jitendraphand/physical-AI-development-kit/projects/shiftgate-rover/media/shiftgate_arena_overview.png

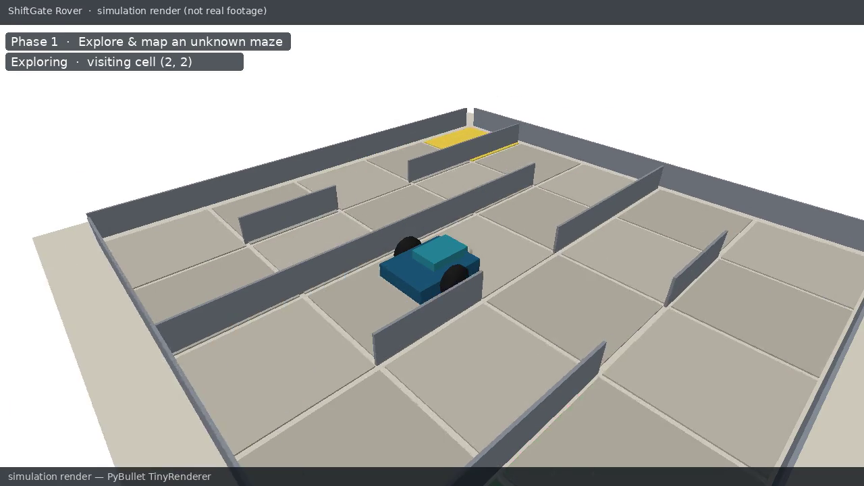
projects/shiftgate-rover/media/shiftgate_arena_overview.png
