jitendraphand/physical-AI-development-kit/projects/shiftgate-rover/cad/step/wheel.step

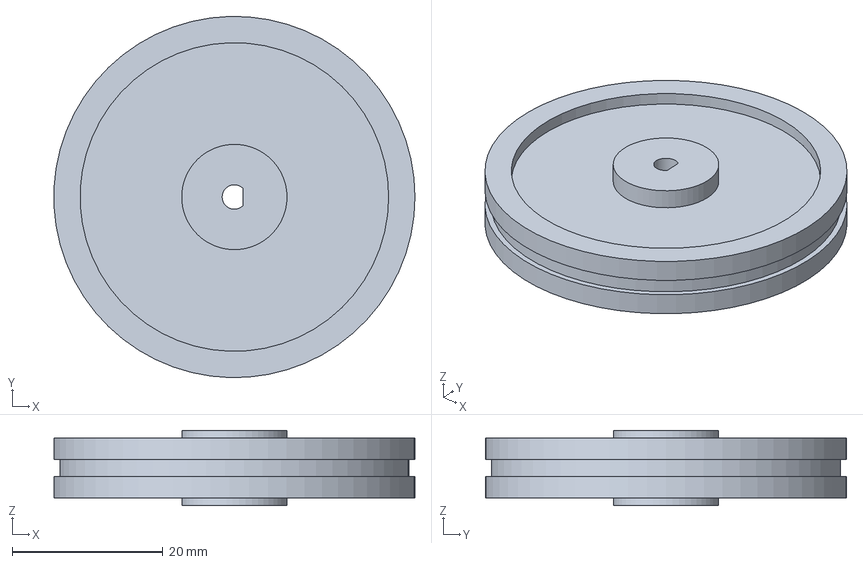
[picture p4: CAD file, 2026-11-13]
projects/shiftgate-rover/cad/step/wheel.step
48.0 x 48.0 x 10.0 mm
