jitendraphand/physical-AI-development-kit/projects/shiftgate-rover/cad/step/motor_clamp.step

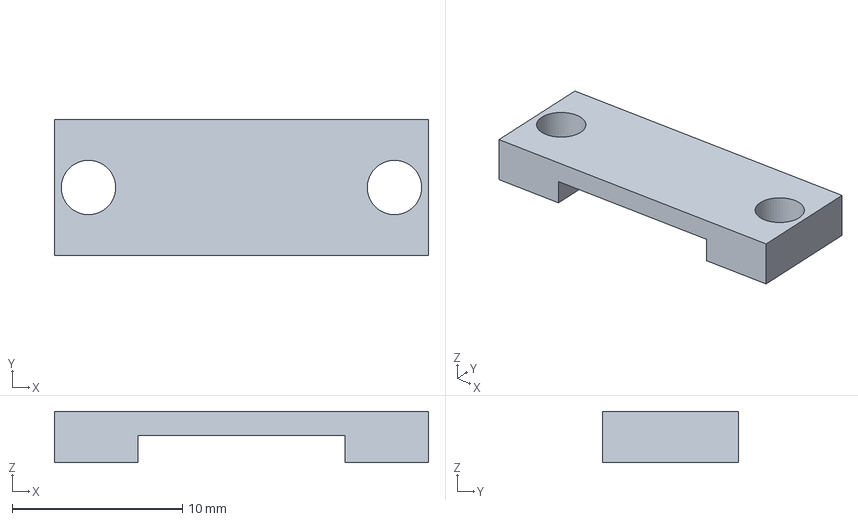
[picture p5: CAD file, 2026-11-13]
projects/shiftgate-rover/cad/step/motor_clamp.step
22.0 x 8.00 x 3.00 mm
