jitendraphand/physical-AI-development-kit/projects/shiftgate-rover/cad/step/gate_segment.step

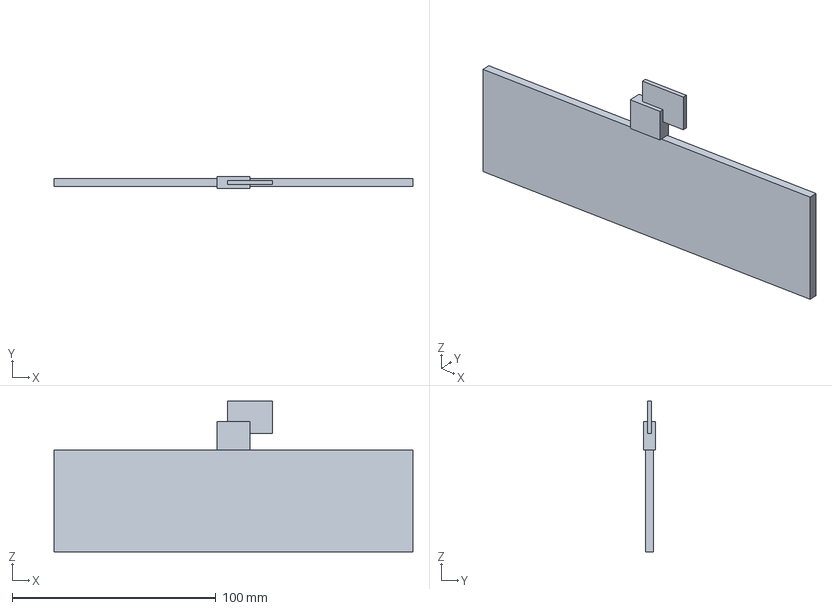
[picture p6: CAD file, 2026-11-13]
projects/shiftgate-rover/cad/step/gate_segment.step
176.0 x 6.00 x 74.0 mm
