jitendraphand/physical-AI-development-kit/projects/shiftgate-rover/cad/step/sensor_bracket_ir.step

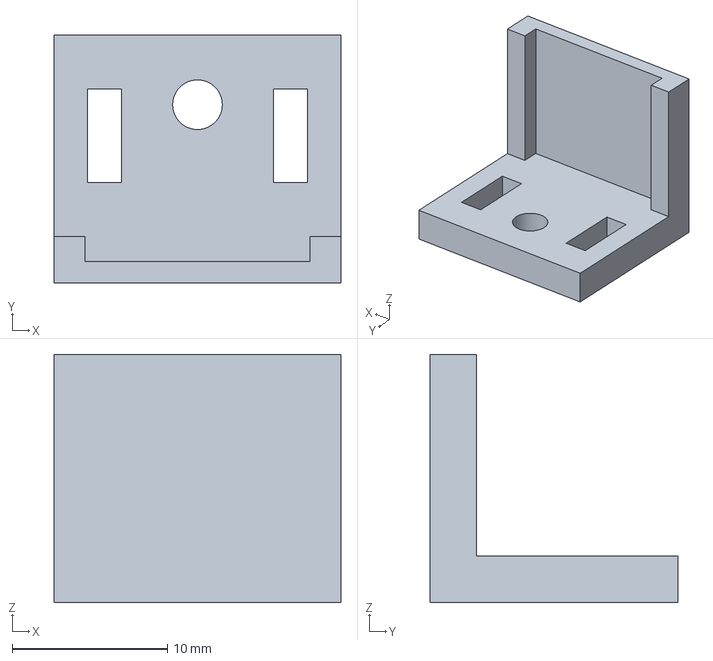
[picture p7: CAD file, 2026-11-13]
projects/shiftgate-rover/cad/step/sensor_bracket_ir.step
18.5 x 16.0 x 16.0 mm
