jitendraphand/physical-AI-development-kit/projects/shiftgate-rover/cad/step/chassis_base.step

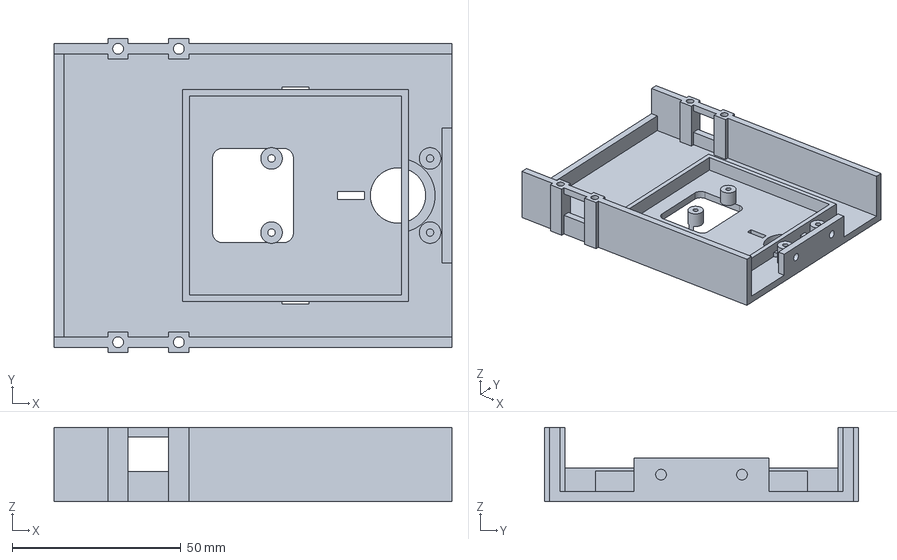
[picture p8: CAD file, 2026-11-13]
projects/shiftgate-rover/cad/step/chassis_base.step
118.0 x 93.0 x 22.0 mm
