jitendraphand/physical-AI-development-kit/projects/shiftgate-rover/cad/step/caster_cup.step

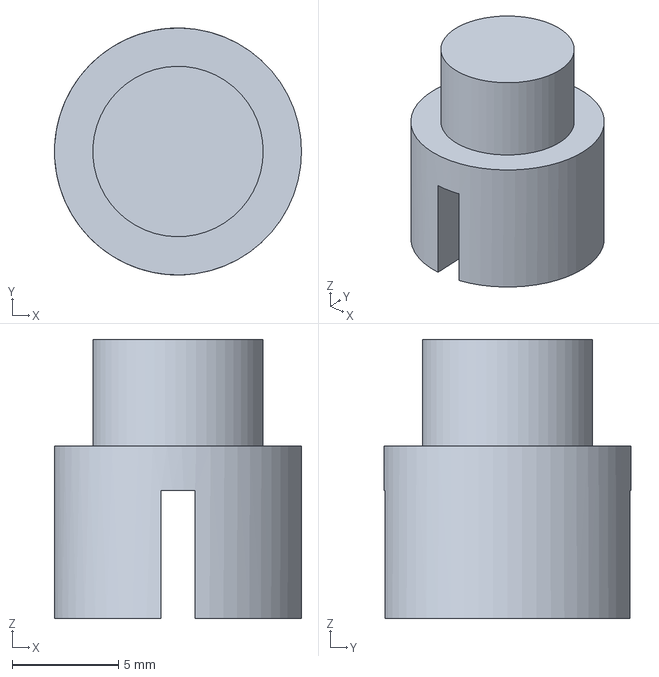
[picture p9: CAD file, 2026-11-13]
projects/shiftgate-rover/cad/step/caster_cup.step
11.6 x 11.6 x 13.1 mm
