jitendraphand/physical-AI-development-kit/projects/shiftgate-rover/cad/step/electronics_cover.step

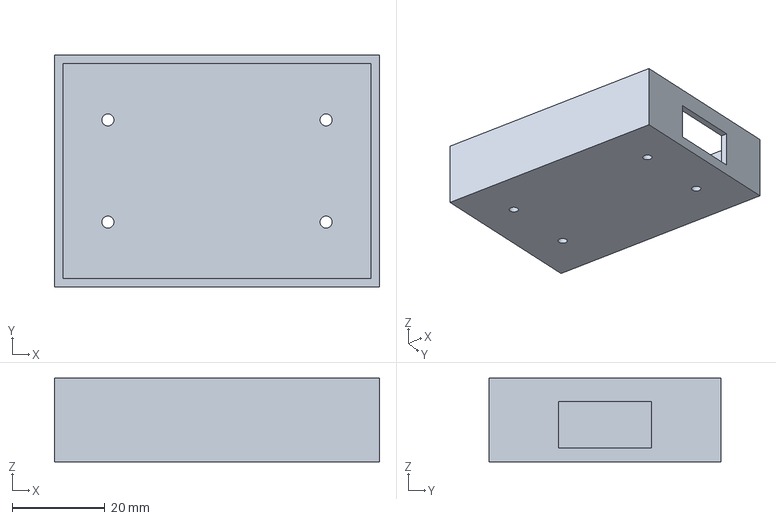
[picture p10: CAD file, 2026-11-13]
projects/shiftgate-rover/cad/step/electronics_cover.step
70.0 x 50.0 x 18.0 mm
