jitendraphand/physical-AI-development-kit/projects/shiftgate-rover/cad/step/alignment_jig.step

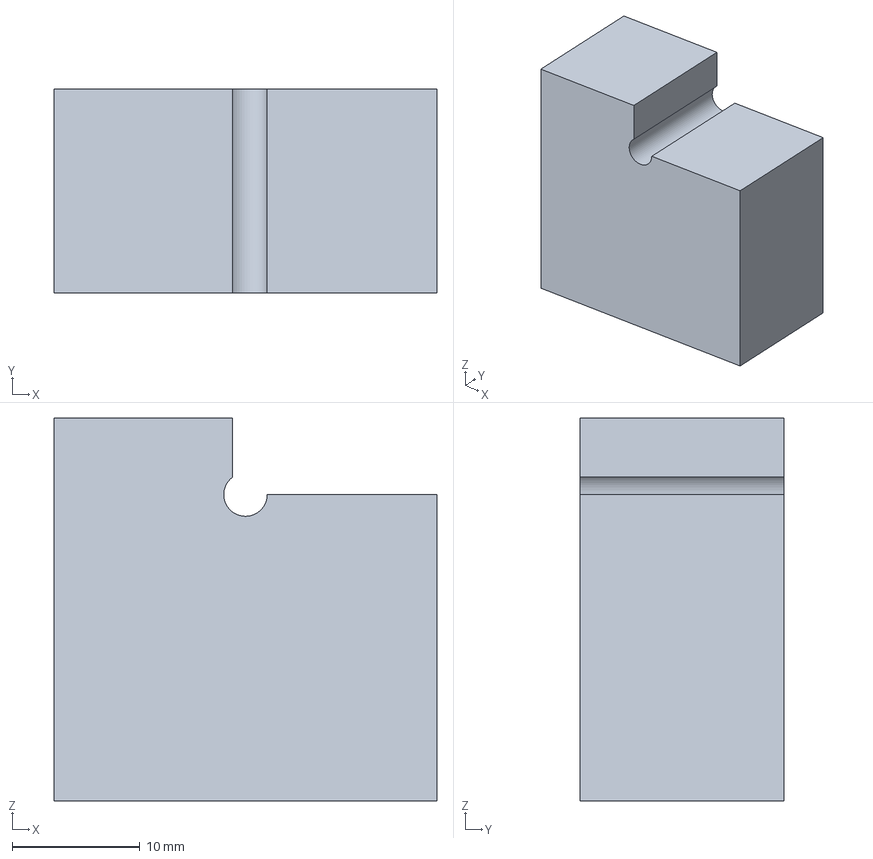
[picture p11: CAD file, 2026-11-13]
projects/shiftgate-rover/cad/step/alignment_jig.step
30.0 x 16.0 x 30.0 mm
