jitendraphand/physical-AI-development-kit/projects/shiftgate-rover/cad/step/wall_post.step

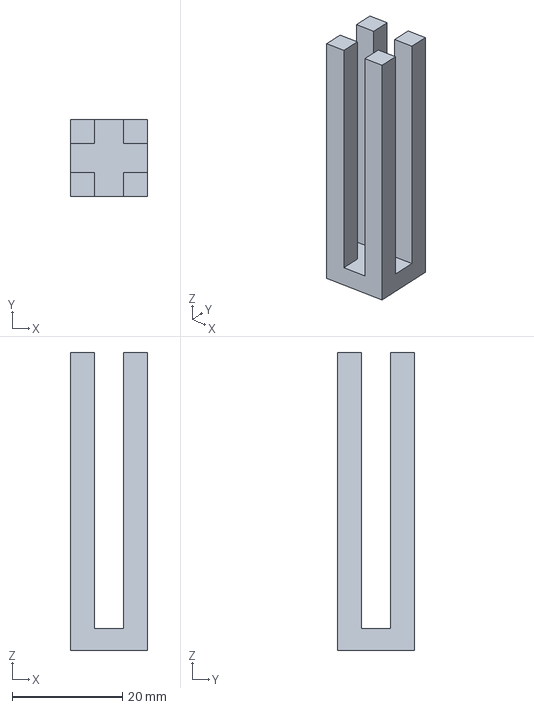
[picture p12: CAD file, 2026-11-13]
projects/shiftgate-rover/cad/step/wall_post.step
14.0 x 14.0 x 54.0 mm
