jitendraphand/physical-AI-development-kit/projects/shiftgate-rover/cad/step/sensor_bracket_us.step

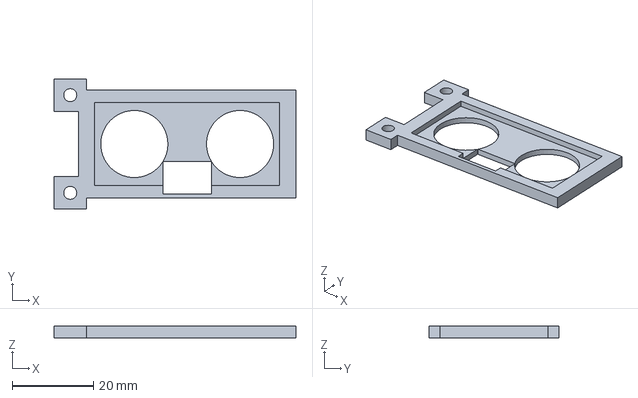
[picture p13: CAD file, 2026-11-13]
projects/shiftgate-rover/cad/step/sensor_bracket_us.step
59.5 x 32.0 x 3.00 mm
