jitendraphand/physical-AI-development-kit/projects/shiftgate-rover/cad/step/wall_clip.step

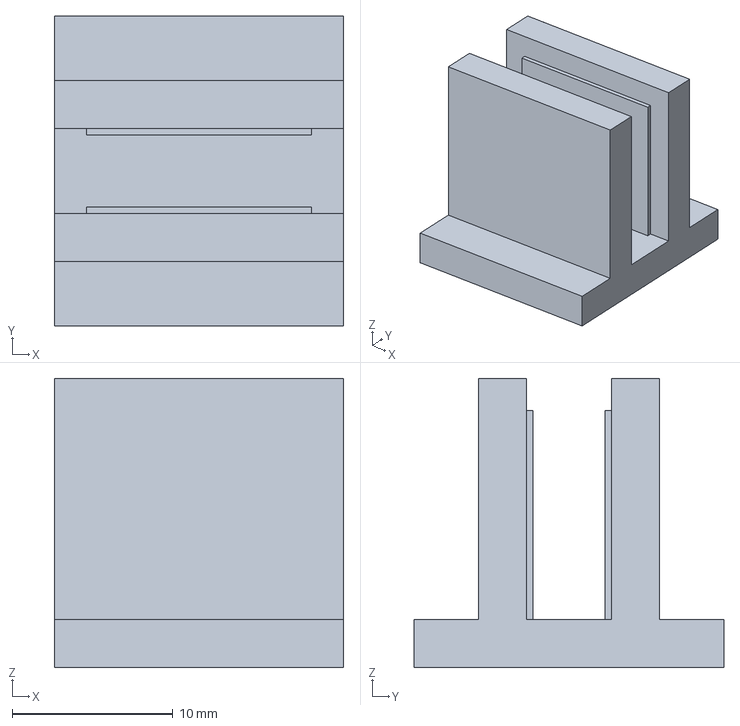
[picture p14: CAD file, 2026-11-13]
projects/shiftgate-rover/cad/step/wall_clip.step
18.0 x 19.3 x 18.0 mm
