jitendraphand/physical-AI-development-kit/projects/shiftgate-rover/cad/step/wall_segment.step

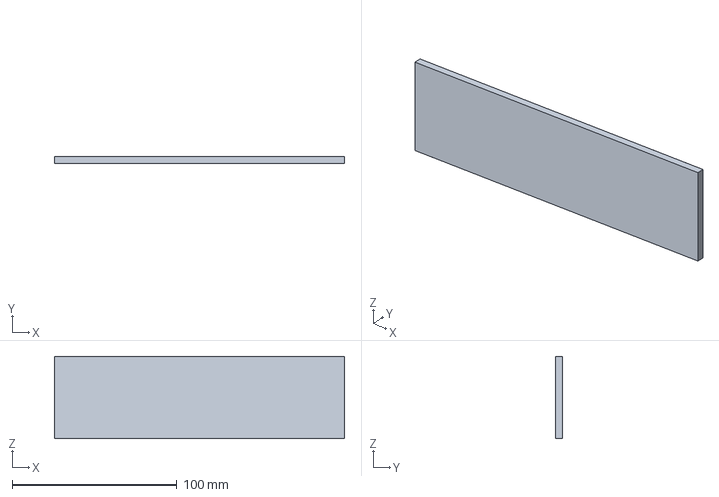
[picture p15: CAD file, 2026-11-13]
projects/shiftgate-rover/cad/step/wall_segment.step
176.0 x 4.00 x 50.0 mm
