jitendraphand/physical-AI-development-kit/projects/shiftgate-rover/cad/step/battery_retainer.step

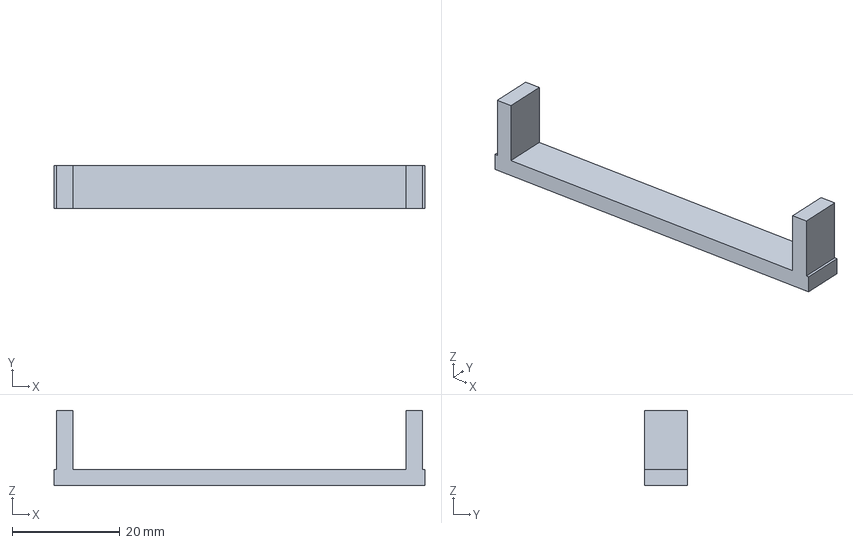
[picture p16: CAD file, 2026-11-13]
projects/shiftgate-rover/cad/step/battery_retainer.step
69.0 x 8.00 x 14.0 mm
