jitendraphand/physical-AI-development-kit/(list of files, cad)

Other CAD files:
projects/shiftgate-rover/cad/stl/alignment_jig.stl
projects/shiftgate-rover/cad/stl/battery_retainer.stl
projects/shiftgate-rover/cad/stl/caster_cup.stl
projects/shiftgate-rover/cad/stl/chassis_base.stl
projects/shiftgate-rover/cad/stl/electronics_cover.stl
projects/shiftgate-rover/cad/stl/gate_segment.stl
projects/shiftgate-rover/cad/stl/motor_clamp.stl
projects/shiftgate-rover/cad/stl/sensor_bracket_ir.stl
projects/shiftgate-rover/cad/stl/sensor_bracket_us.stl
projects/shiftgate-rover/cad/stl/wall_clip.stl
projects/shiftgate-rover/cad/stl/wall_post.stl
projects/shiftgate-rover/cad/stl/wall_segment.stl
projects/shiftgate-rover/cad/stl/wheel.stl
