jitendraphand/physical-AI-development-kit/(commit log)

2026-11-13 Add parametric ShiftGate CAD, watertight STL/STEP, and print settings.
    CadQuery generates all 13 printable parts; the same names have a FreeCAD
    headless script for labs that already run FreeCADCmd. Every shipped STL
    was exported here and verified watertight with trimesh. Print settings
    (PLA, orientation, infill, time and filament estimates) live in
    print_settings.yaml.
    [alignment_jig.step, alignment_jig.stl, battery_retainer.step, battery_retainer.stl, caster_cup.step, caster_cup.stl, chassis_base.step, chassis_base.stl]
2026-11-13 Add ESP32 firmware, wiring, ROS 2 packages, and CI-lite tests.
    PlatformIO firmware covers motors, encoders, the HC-SR04 (with a 3.3 V
    echo divider), and a serial fallback if micro-ROS is not installed yet.
    The ROS 2 workspace has a URDF, Gazebo Classic and Harmonic worlds for
    the stock maze, and a mission node that wraps shiftgate_core. GitHub
    Actions runs the unit tests, simulate.py --check, and the STL watertight
    check. Gazebo itself was not executed on the authoring machine.
    [shiftgate.urdf.xacro, shiftgate_harmonic.sdf]
2026-11-13 Add the ShiftGate curriculum, India BOM, and step-by-step build guide.
    Learning outcomes are measurable per module (CAD, firmware, ROS 2,
    occupancy, planning, discrepancy replanning, sim-to-real) with a 0–3
    rubric. The BOM uses supplier links checked on 13 Nov 2026 and totals
    about ₹2,400–2,700, under the ₹3,500 target. The build guide covers
    printing, arena cutting, wiring, flashing, and the silent-gate mission.
2026-11-13 Add a labelled Blender CAD render of the assembled rover in the maze.
    The 8 s 1280x720 EEVEE clip is a CAD render, not real footage, and is
    linked from the project README.
